zesinger/ZeDART_GNSS_NTP_Server/(commit log)

2026-10-16 Revise README for ZeDART GNSS NTP Server
    Updated README to provide detailed information about the ZeDART GNSS NTP server, including functionality, hardware requirements, wiring, network modes, software requirements, and testing procedures.
2026-10-17 Enhance README with RGB LED status information
    Added RGB status LED indications and wiring details.
2026-10-17 Revise resistor values for LED channels
    Updated resistor values for Green and Blue channels in the LED table.
2026-10-17 Fix resistor values for GPIO connections in README
2026-10-18 Document NETWORK LED behavior on NTP response
    Added details about the NETWORK LED activity flash on NTP response.
2026-10-18 Replace text wiring diagram with image
    Removed the text-based wiring diagram for RGB LEDs and replaced it with an image.
